prrtzel/GeorgeOS-Single-Board-Computer/README.md

# GeorgeOS Single Board Computer

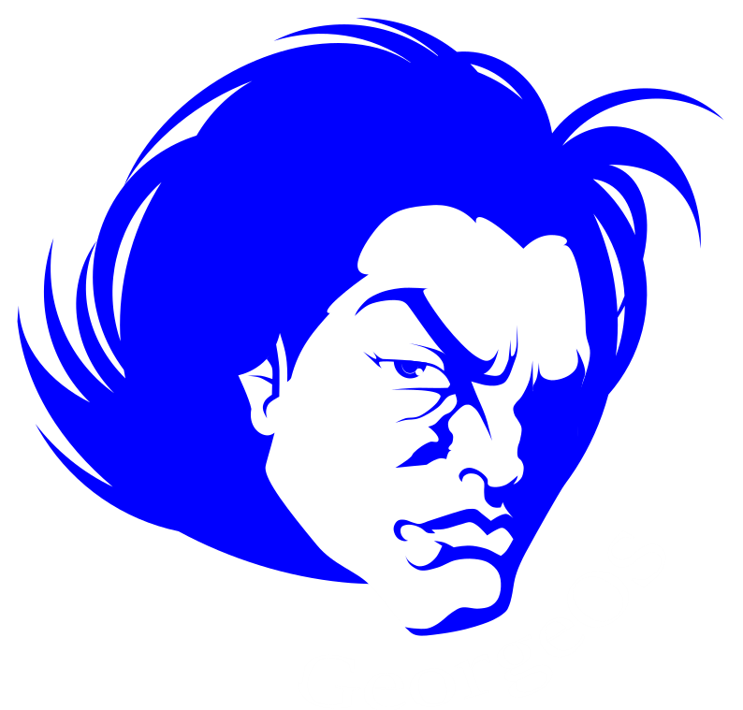
[picture p1: Docs/Pictures/GeorgeOS.png]


This was the final project for the Microcomputer Design Course at LeTourneau University.

Software for this project can be found here: [Morg Monitor Program](https://github.com/prrtzel/Morg-Monitor-Program)

The schematic and PCB designs can be viewed in detail using the 
[Kicanvas Online Viewer](https://kicanvas.org/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)

The requirements for the project were as follows:

- Read from memory
- Write to memory
- Read from registers
- Write to registers
- Load an S-Record file
- Jump to the S-Record file and run it

## Schematic
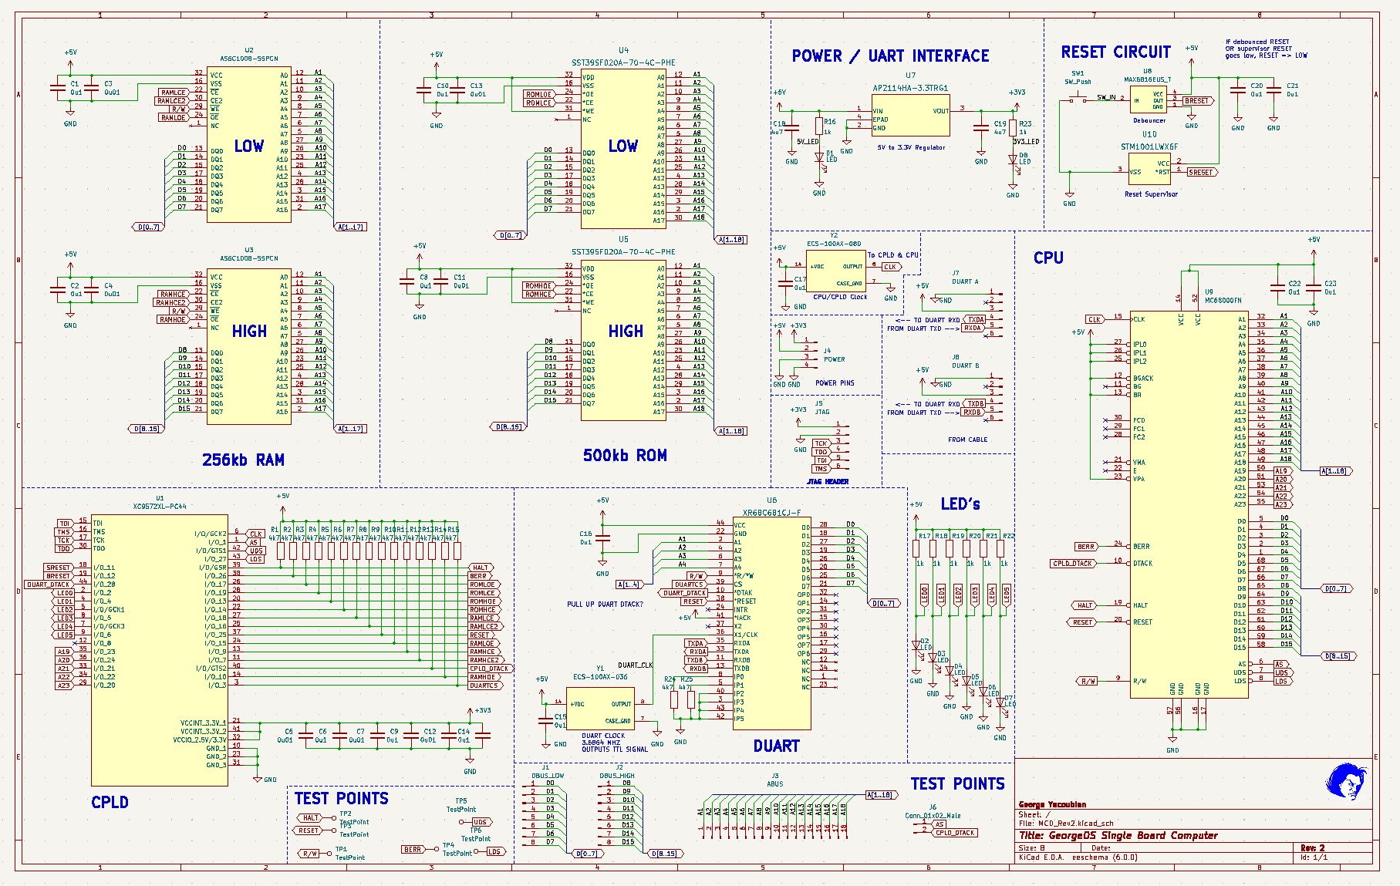
[picture p2: Docs/Pictures/schematic.PNG]
Schematic

## Printed Circuit Board
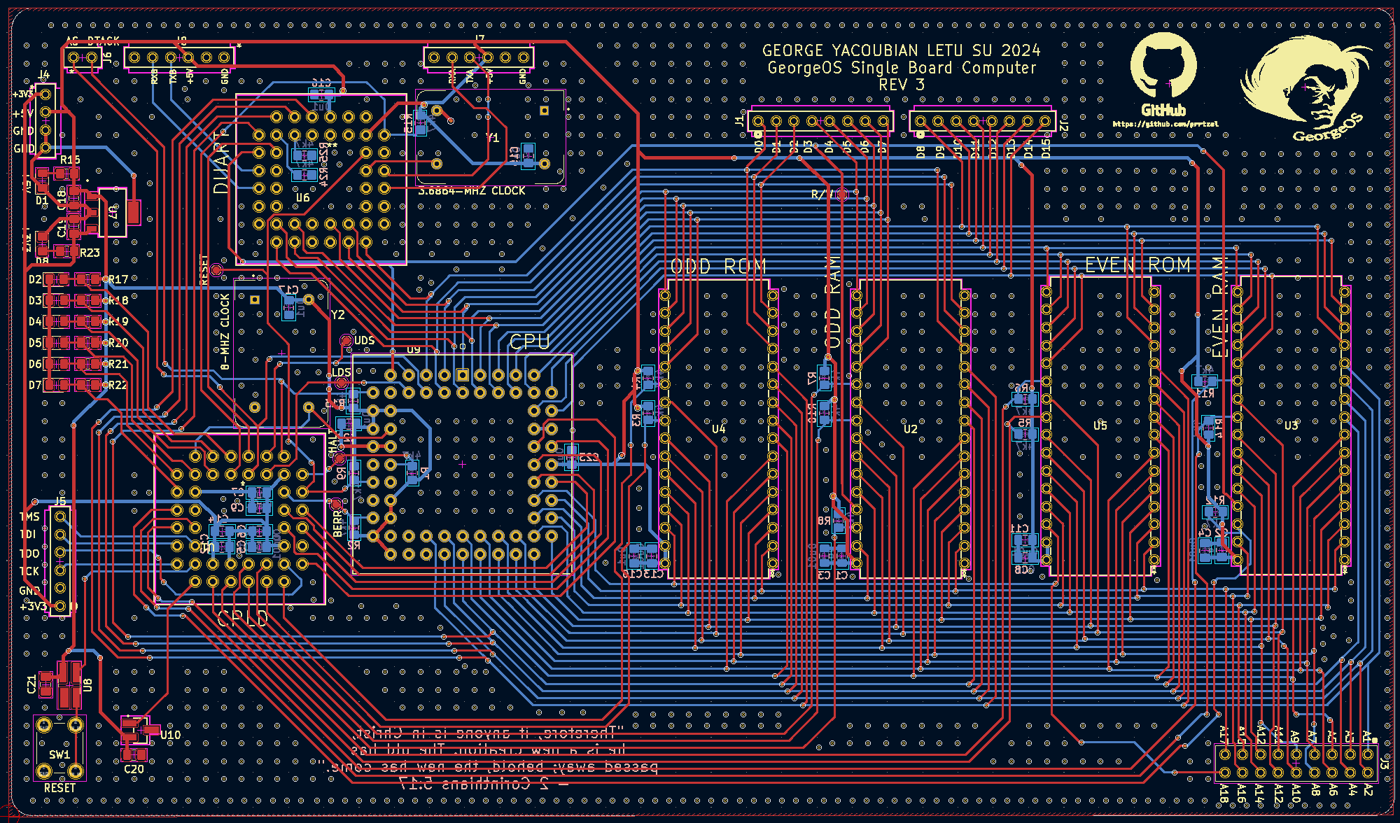
[picture p3: Docs/Pictures/PCB.PNG]
PCB

## Assembled Board
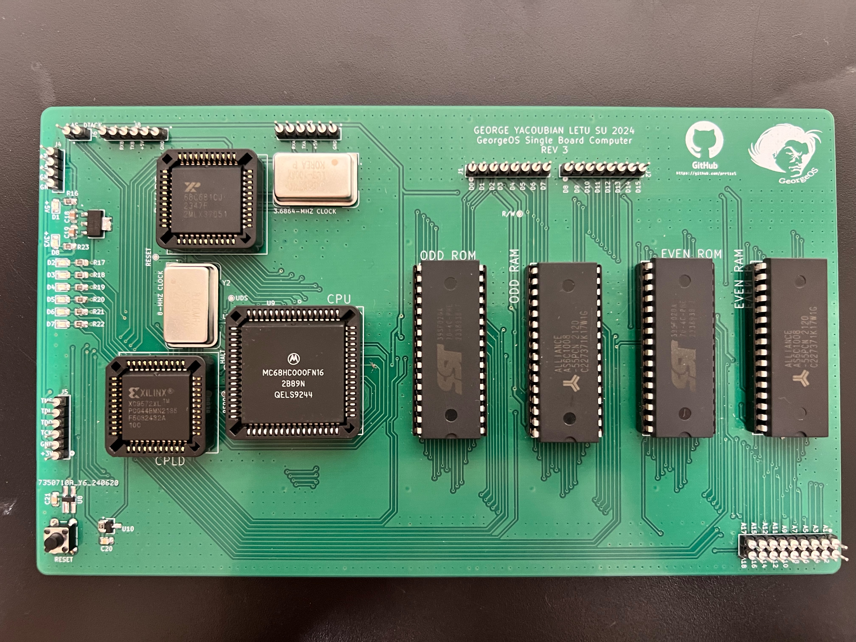
[picture p4: Docs/Pictures/MCD-Rev3-Board.jpeg]
Final Product


## Hardware Specifications
- Motorola 68000 32-bit CPU with an 8MHz clock speed
- Xilinx XC9572XL CPLD for address decoding / glue logic
- Dual channel UART interface for serial communication
